nottelegraham/AlkTrack/Formula.png

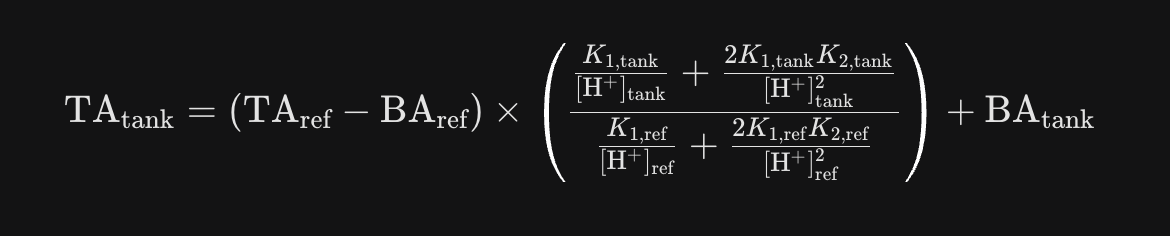
Formula.png
