nottelegraham/AlkTrack/thumbnail.png

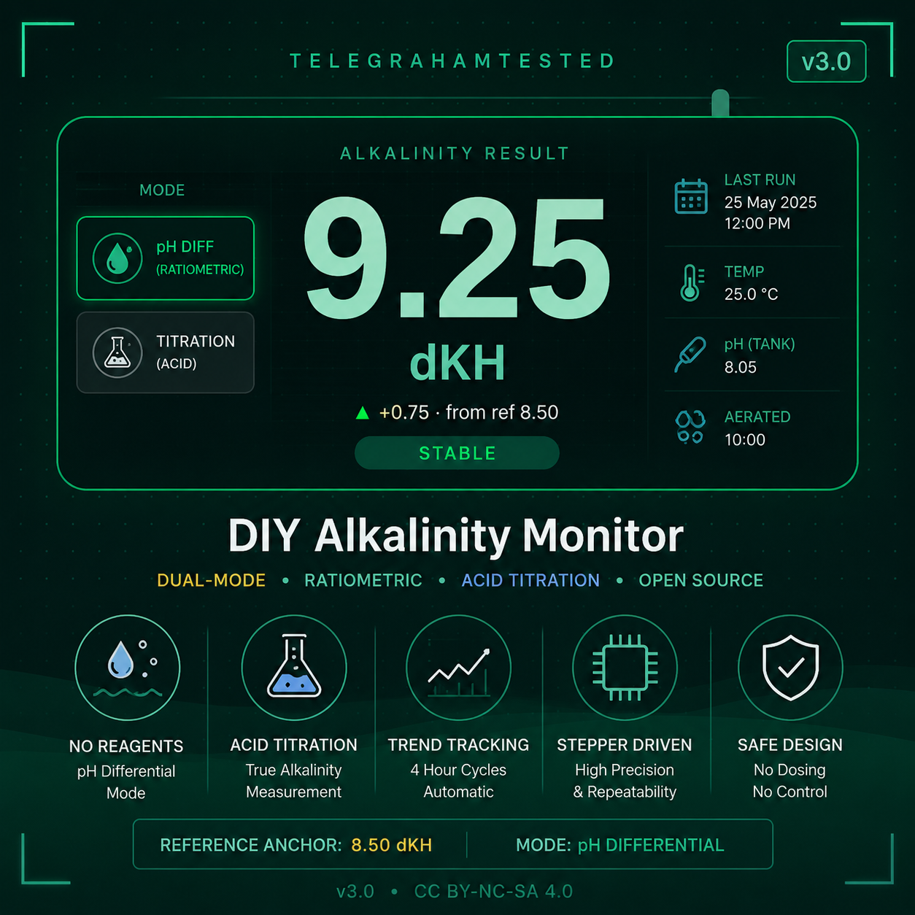
thumbnail.png
