nottelegraham/AlkTrack/DIY_Alkalinity_Monitor_Price_Sheet_v3_0.xlsx

AlkTrack DIY Alkalinity Monitor — v3.0 Component Price Sheet
TelegrahamTested • Firmware v3.0 • Dual-mode pH differential + acid titration • Approx. US retail
Qty | Item | Notes | Low ($) | High ($) | Subtotal (mid)
ELECTRONICS
1 | ESP32 DevKit C (38-pin) | Espressif or clone. Use 38-pin standard pinout; avoid ESP32 GPIO 6-11. | $8.00 | $12.00 | $10.00
1 | Atlas Scientific EZO-pH Circuit | Recommended pH interface. Cheap high-impedance boards often drift/noise. | $43.00 | $47.00 | $45.00
1 | Atlas EZO isolated carrier board | Mandatory isolation between pH circuit and pump/driver power. | $23.00 | $27.00 | $25.00
1 | Lab-grade double-junction pH probe | BNC, gel-filled, epoxy/Ultem body. Most important purchase. | $60.00 | $130.00 | $95.00
1 | DS18B20 waterproof temperature probe | 1-wire digital probe, 4.7 kΩ pullup required. | $5.00 | $8.00 | $6.50
4 | A4988 or DRV8825 stepper drivers | One per pump; set current limit and use heat sinks. | $3.00 | $7.00 | $20.00
1 | 12V DC supply, 5A minimum | Stepper-driven pumps require more current than v2 relay pumps. | $14.00 | $25.00 | $19.50
1 | 5V/USB supply for ESP32 | Separate logic supply recommended. | $5.00 | $8.00 | $6.50
1 | Perfboard / terminal blocks / wiring | For tidy wiring, pullup, and service loops. | $8.00 | $20.00 | $14.00
PUMPS & FLUIDICS
1 | Stepper peristaltic pump A | Reference reservoir to/from reaction chamber; reversible. | $35.00 | $70.00 | $52.50
1 | Stepper peristaltic pump B | Tank/sample fill pump; step-counted volume control. | $35.00 | $70.00 | $52.50
1 | Stepper peristaltic pump C | Reaction chamber drain/evacuation; routes titration waste to waste container. | $35.00 | $70.00 | $52.50
1 | Stepper peristaltic pump D | Acid reagent dosing pump. Highest calibration priority. | $35.00 | $80.00 | $57.50
1 | Micro diaphragm air pump | Fine bubbles for aeration and titration mixing pulses. | $8.00 | $15.00 | $11.50
1 | Ceramic fine-bubble airstone | Small enough for 40-60 mL chamber. | $2.00 | $5.00 | $3.50
4 | Tubing, 3 mm ID, peristaltic compatible | Meters. Buy extra for calibration and replacement. | $3.00 | $5.00 | $16.00
1 | Bulkhead fittings / tube glands set | Ports for chamber, reservoirs, and rear panel. | $10.00 | $20.00 | $15.00
CONTAINERS & HARDWARE
1 | Reference reservoir bottle | 500-1000 mL HDPE or Nalgene-style bottle. | $12.00 | $30.00 | $21.00
1 | Acid reagent reservoir | 250-500 mL acid-resistant HDPE bottle; label ACID - HCl. | $8.00 | $20.00 | $14.00
1 | Waste collection container | Closed HDPE container for acidified titration waste. | $5.00 | $12.00 | $8.50
1 | Reaction chamber / measurement cell | 40-60 mL clear acrylic/PETG with pH, temp, air, sample, drain, and acid ports. | $20.00 | $60.00 | $40.00
1 | Electronics enclosure | ABS project box; separate wet and dry areas. | $12.00 | $25.00 | $18.50
1 | Drip tray / leak containment | Recommended under wet components. | $5.00 | $20.00 | $12.50
1 | Misc. sealant, cable clips, labels | Mounting, waterproofing, acid/waste labels. | $8.00 | $15.00 | $11.50
CONSUMABLES
1 | 0.1N HCl titrant or known-normality acid | Required only for MODE TITR. Store capped and labelled. | $10.00 | $25.00 | $17.50
1 | pH 7.00 and pH 4.01 calibration buffers | Required for pH probe calibration. | $8.00 | $20.00 | $14.00
1 | Baking soda for neutralizing waste | Required for acid waste neutralization. | $2.00 | $5.00 | $3.50
PHYSICAL BUILD / TOOLS
1 | Reaction chamber fabrication | DIY drilling/tapping or outsourced 3D print/machining. | $0.00 | $60.00 | $30.00
1 | Step drill bits / hole saws | For enclosure cutouts and bulkhead fittings. | $0.00 | $20.00 | $10.00
1 | Solder, heat shrink, connectors | Wiring consumables. | $5.00 | $15.00 | $10.00
SUMMARY |  |  | Low ($) | High ($) | Mid ($)
Electronics |  |  | $169.00 | $284.00 | $241.50
Pumps & Fluidics |  |  | $163.00 | $335.00 | $261.00
Containers & Hardware |  |  | $70.00 | $182.00 | $126.00
Consumables |  |  | $20.00 | $50.00 | $35.00
Physical Build / Tools |  |  | $5.00 | $95.00 | $50.00
COMPONENTS TOTAL |  |  | $427.00 | $946.00 | $713.50
Notes
v3.0 includes both pH differential and acid titration modes. Titration mode requires acid reagent, Pump D, and an acid waste container.
Do not return titration waste to the aquarium. Any sample that receives acid must go to waste and be neutralized before disposal.
pH probe quality and pump calibration dominate measurement reliability.
