nottelegraham/AlkTrack/Version 2/DIY_Alkalinity_Monitor_Price_Sheet.xlsx

DIY Ratiometric Alkalinity Monitor — Component Price Sheet
TelegrahamTested • Firmware v2.2 • All prices approximate US retail
Qty | Item | Notes | Low ($) | High ($) | Subtotal (mid)
ELECTRONICS
1 | ESP32 DevKit C (38-pin) | Espressif or clone. Must be 38-pin standard pinout. Do not buy the 30-pin variant. | $8.00 | $12.00 | $10.00
1 | Atlas Scientific EZO-pH Circuit | Isolated version (EZO-pH). Cheap alternatives produce unusable noise. | $43.00 | $47.00 | $45.00
1 | Atlas EZO Isolated Carrier Board | Part: EZO-PMP-ISO. Mandatory — eliminates pump motor noise from pH readings. | $23.00 | $27.00 | $25.00
1 | Lab-grade double-junction pH probe | BNC connector, gel-filled, epoxy/Ultem body. Atlas or Hanna HI1083. This is the most critical purchase — do not skimp. | $60.00 | $130.00 | $95.00
1 | DS18B20 waterproof temp probe | 1-meter stainless steel sheath. 1-Wire digital. Any brand. | $5.00 | $8.00 | $6.50
1 | 4-channel relay module, 5V opto-isolated | Controls all 4 pumps. Must be opto-isolated. Active-LOW most common — see wiring notes. | $7.00 | $10.00 | $8.50
1 | 4.7 kΩ resistor | Pullup for DS18B20 data line. Often included in DS18B20 kits. | $0.50 | $1.00 | $0.75
1 | 12V 2A DC power supply | Powers pumps. Standard barrel connector. | $8.00 | $12.00 | $10.00
1 | 5V 1A supply or USB phone charger | Powers ESP32. | $5.00 | $8.00 | $6.50
1 | Breadboard or small perfboard | For pullup resistor and wiring connections. | $3.00 | $6.00 | $4.50
1 | Jumper wire assortment | Male-to-male and male-to-female, 20 cm. | $5.00 | $8.00 | $6.50
PUMPS & FLUIDICS
1 | Reversible peristaltic pump, 12V (Pump A) | Must run both directions. Kamoer FX-STP or similar. Draws from and returns to reference reservoir. | $35.00 | $60.00 | $47.50
1 | Reversible peristaltic pump, 12V (Pump B) | Must run both directions, same as Pump A. Draws tank water in and returns it to the sump after measurement. Kamoer FX-STP or similar. | $35.00 | $60.00 | $47.50
1 | Micro diaphragm air pump | 5V or 12V. Fine bubbles required. Tetra Whisper or small aquarium air pump. | $8.00 | $12.00 | $10.00
1 | Ceramic fine-bubble airstone | Small, fits inside reaction chamber. Pre-soak in RO water before first use. | $2.00 | $5.00 | $3.50
2 m | Silicone tubing, 3 mm ID | Food-safe, peristaltic-pump compatible. Buy extra for calibration runs. | $6.00 | $10.00 | $8.00
4 | Barbed fittings & check valves | Prevents back-siphoning. Critical if sump is above the chamber. | $8.00 | $12.00 | $10.00
CONTAINERS & HARDWARE
1 | Reference reservoir bottle | 500–1000 mL HDPE, wide-mouth. Requires three cap ports: Pump A tubing, PTFE vent plug, and one spare. Nalgene or equivalent. | $12.00 | $30.00 | $21.00
2 | PTFE hydrophobic membrane vent plug | Polytetrafluoroethylene membrane vent for reservoir cap. Allows pressure equalization without liquid evaporation. CO₂ passing through does NOT affect alkalinity — TA is conserved. One installed, one spare. Lab supply or aquarium store. | $2.00 | $8.00 | $5.00
1 | Reaction chamber / measurement cell | 40–60 mL. Clear acrylic tube + end caps, or 3D-printed PETG. Needs ports for pH probe, temp probe, airline, sample in, drain out. | $20.00 | $50.00 | $35.00
1 | Electronics enclosure | ABS project box. Weatherproof if near sump. | $10.00 | $15.00 | $12.50
1 | Bulkhead fittings, 1/4" or 3/8" | Seals tubing penetrations into reservoir and chamber walls. | $8.00 | $12.00 | $10.00
1 | Misc: zip ties, sealant, cable clips | Mounting, waterproofing, cable management. | $6.00 | $10.00 | $8.00
PHYSICAL BUILD (NOT INCLUDED ABOVE)
— | Fabrication — reaction chamber ports | Drilling and tapping probe/tube ports into acrylic or PETG. DIY: ~$0 if you own a drill. Professional shop: variable. | $0.00 | $60.00 | $30.00
— | 3D printing — reaction chamber shell | If outsourcing. JLCPCB or local shop. DIY with own printer: filament ~$2. | $0.00 | $40.00 | $20.00
— | Solder, heat shrink, connectors | Misc electronics consumables for wiring the relay module and probe connections. | $5.00 | $15.00 | $10.00
— | Step drill bits for enclosure cutouts | For probe glands, cable glands, and power entry in the electronics box. | $0.00 | $20.00 | $10.00
— | Drip tray | Under all fluidic components. Tupperware or custom-cut acrylic sheet. | $5.00 | $20.00 | $12.50
SUMMARY |  |  | Low ($) | High ($) | Mid ($)
Electronics |  |  | $167.50 | $269.00 | $218.25
Pumps & Fluidics |  |  | $94.00 | $159.00 | $126.50
Containers & Hardware |  |  | $58.00 | $125.00 | $91.50
Physical Build (additional) |  |  | $10.00 | $155.00 | $82.50
COMPONENTS TOTAL |  |  | $319.50 | $553.00 | $436.25
ALL-IN ESTIMATE (incl. physical build) |  |  | $329.50 | $708.00 | $518.75
⚠ pH probe is the most critical purchase. A cheap probe makes the device useless — the ΔpH signal is only 0.02 pH per 0.5 dKH change.
⚠ Physical build costs assume DIY fabrication. Professional machining or outsourced 3D printing adds cost not captured above.
ℹ Prices are approximate US retail (2024–2025). Amazon, Digikey, Atlas Scientific, and BRS are the primary sources.
ℹ Tools not included: soldering iron, drill, multimeter, wire strippers. Add ~$50–$100 if starting from scratch.
