nottelegraham/AlkTrack/DIY_Alkalinity_Monitor_Build_Guide.docx

AlkTrack DIY Alkalinity Monitor

Complete Build Guide • TelegrahamTested • Firmware v3.0 • Dual-mode pH differential + acid titration

# 1. What This Device Does

AlkTrack v3.0 is a DIY, non-commercial reef aquarium alkalinity monitor with two selectable modes. In pH differential mode, it estimates alkalinity trend by comparing an aerated reference sample and an aerated tank sample. In acid titration mode, it performs a traditional fixed-volume acid-demand alkalinity test.

WARNING: Version 3.0 is not only a reagent-free trend monitor. Titration mode consumes known-strength acid reagent and produces acidic waste.

## Operating Modes

Mode | What it uses | What it produces | Best use
pH differential (MODE PHDI) | Reference reservoir, tank sample, air pump, pH probe, temperature probe | Reference-anchored alkalinity trend estimate | Monitoring direction: rising, falling, stable
Acid titration (MODE TITR) | Fixed tank-water sample, 0.1N acid reagent, pH endpoint detection | True acid-demand alkalinity result | Periodic confirmation or higher-confidence automated test

## How the Math Works

pH differential mode uses the reference-anchored carbonate-speciation ratio:

TA_tank = (TA_ref - BA_ref) × carbonate_speciation_ratio + BA_tank

The carbonate speciation ratio compares K1, K2, and hydrogen ion activity derived from the reference and tank pH readings. This is a trend estimator, not a laboratory-grade absolute method.

Acid titration mode uses:

dKH = (N_acid × V_acid_mL / V_sample_mL) × 2800

The factor 2800 converts equivalents per liter to dKH when acid normality is in eq/L and both volumes are in mL.

# 2. Shopping List

All prices are approximate US retail. Exact models can vary; what matters is meeting the specification in the Notes column.

## Electronics

Qty | Item | Notes | Est. Cost
1 | ESP32 DevKit C (38-pin) | Espressif or equivalent. Avoid 30-pin variants if you need all listed GPIO. | $8-$12
1 | Atlas Scientific EZO-pH Circuit | Use a reliable high-impedance pH interface. Atlas EZO-pH is the recommended baseline. | $43-$47
1 | Atlas electrically isolated carrier board | Mandatory for stable pH readings near pump wiring. | $23-$27
1 | Lab-grade double-junction pH probe | BNC connector, gel-filled, epoxy or Ultem body. Do not use a bargain probe. | $60-$130
1 | DS18B20 waterproof temperature probe | 1-wire digital temperature probe with 4.7 kΩ pullup. | $5-$8
4 | A4988 or DRV8825 stepper drivers | One driver per pump. Use heat sinks and set current limit correctly. | $12-$28
1 | 12V DC power supply, 5A minimum | Stepper pumps require more current than relay-switched DC pumps. | $14-$25
1 | 5V/USB supply for ESP32 | Separate logic power is recommended. | $5-$8
1 | Perfboard / terminal blocks / wiring | For clean connections and serviceability. | $8-$20

## Pumps and Fluidics

Qty | Item | Notes | Est. Cost
1 | Stepper peristaltic pump A | Reference reservoir to/from reaction chamber. Reversible. | $35-$70
1 | Stepper peristaltic pump B | Tank/sample fill pump. Step-counted volume control. | $35-$70
1 | Stepper peristaltic pump C | Chamber drain/evacuation pump. Routes to waste in titration mode. | $35-$70
1 | Stepper peristaltic pump D | Acid reagent dosing pump. Highest calibration priority. | $35-$80
1 | Micro diaphragm air pump | Provides repeatable aeration/mixing pulses. | $8-$15
1 | Ceramic fine-bubble airstone | Small enough for the reaction chamber. | $2-$5
2-4 m | Peristaltic-compatible tubing | Buy extra for calibration, replacement, and mistakes. | $8-$16
— | Bulkhead fittings / tubing glands | For chamber, reservoir, acid bottle, and rear panel. | $10-$20

## Containers and Hardware

Qty | Item | Notes | Est. Cost
1 | Reference reservoir bottle | 500-1000 mL HDPE or Nalgene-style bottle. | $12-$30
1 | Acid reagent reservoir | 250-500 mL acid-resistant HDPE bottle labelled ACID - HCl. | $8-$20
1 | Waste collection container | Closed HDPE container labelled ACID WASTE. Required for titration mode. | $5-$12
1 | Reaction chamber / measurement cell | 40-60 mL clear acrylic/PETG chamber with probe, air, sample, drain, and acid ports. | $20-$60
1 | Electronics enclosure | ABS project box. Keep fluidics separated from electronics. | $12-$25
— | Drip tray / leak containment | Recommended under all wet components. | $5-$20

# 3. Wiring

The ESP32 does not drive stepper motors directly. Each peristaltic pump uses one A4988 or DRV8825 driver. The ESP32 sends STEP and DIR pulses; firmware converts calibrated steps to mL.

WARNING: Do not use ESP32 GPIO 6, 7, 8, 9, 10, or 11. These are connected to internal SPI flash.

Function | ESP32 GPIO | Connect to
Pump A STEP | GPIO 23 | Pump A stepper driver STEP
Pump A DIR | GPIO 22 | Pump A stepper driver DIR
Pump B STEP | GPIO 21 | Pump B stepper driver STEP
Pump B DIR | GPIO 19 | Pump B stepper driver DIR
Pump C STEP | GPIO 18 | Pump C stepper driver STEP
Pump C DIR | GPIO 5 | Pump C stepper driver DIR
Pump D STEP | GPIO 27 | Pump D acid pump driver STEP
Pump D DIR | GPIO 26 | Pump D acid pump driver DIR
Air pump | GPIO 4 | MOSFET or relay driver for air pump
DS18B20 data | GPIO 14 | DS18B20 yellow/data wire + 4.7 kΩ pullup
EZO-pH RX | GPIO 16 | EZO carrier TX
EZO-pH TX | GPIO 17 | EZO carrier RX
Optional DAC output | GPIO 25 | Isolated DAC or buffer stage only

## Stepper Driver Notes

- Set current limits before connecting pumps.
- Use 1/16 microstepping for water pumps as a starting point.
- Use 1/16 or 1/32 microstepping for the acid pump if the driver and pump support it.
- All volume-critical pumps must be calibrated in steps per mL before use.
- Keep pH signal wiring physically separated from motor wiring.

# 4. Fluidic Layout

Recommended v3.0 dual-mode fluid path:

Pump | Inlet | Outlet | Purpose
Pump A | Reference reservoir | Reaction chamber | Fill/reference return path; reversible
Pump B | Sump or tank sample inlet | Reaction chamber | Step-counted tank/sample fill
Pump C | Reaction chamber | Waste container or controlled drain | Evacuates chamber; routes acidic titration waste away from tank
Pump D | Acid reagent reservoir | Reaction chamber | Adds measured acid increments in titration mode

WARNING: Do not return titration waste to the aquarium. Any sample that receives acid reagent must go to a waste container.

# 5. Software Setup

1. Install Arduino IDE 2.x.
2. Install ESP32 board support by Espressif Systems.
3. Install OneWire and DallasTemperature libraries if SIMULATION_MODE is false.
4. Open alkalinity_monitor_v3_0.ino.
5. Verify and upload with SIMULATION_MODE true for bench testing.
6. Open Serial Monitor at 115200 baud and send STATUS.
7. After wiring and calibration, set SIMULATION_MODE false and re-upload.

# 6. First-Time Calibration

## pH differential mode

8. Fill the reference reservoir with fresh aquarium water.
9. Manually test that exact water with a hobby alkalinity titration kit.
10. Enter the value with CAL 8.50, replacing 8.50 with your measured dKH.
11. Prime Pump A and tank lines with PRIME.
12. Select MODE PHDI and run RUN.

## Titration mode

13. Prepare labelled 0.1N HCl reagent or another known-normality acid.
14. Set acid normality, for example CAL ACID 0.1000.
15. Set sample volume, for example CAL SAMPLEML 25.0.
16. Calibrate sample pump steps/mL with CAL SAMPLESPM.
17. Calibrate acid pump steps/mL with CAL ACIDSPM.
18. Select MODE TITR and run RUN.
19. Confirm first results against a manual test before trusting automation.

# 7. Safety

- Use eye protection when handling acid reagent.
- Label acid and waste containers clearly.
- Neutralize acidic waste with baking soda before disposal.
- Never route acid-exposed sample water back to the aquarium.
- Use a drip tray and keep electronics above and separated from the wet bay.
- Do not let AlkTrack directly control dosing without conservative safeguards and manual confirmation.

TelegrahamTested • AlkTrack v3.0 • CC BY-NC-SA 4.0
