nottelegraham/AlkTrack/DIY_Alkalinity_Monitor_User_Guide.docx

AlkTrack DIY Alkalinity Monitor

User Guide • TelegrahamTested • Firmware v3.0 • Dual operating modes

# What this device does

AlkTrack v3.0 can operate in two user-selectable modes.

- MODE PHDI: pH differential/ratiometric alkalinity trend monitoring. Reagent-free, reference-anchored, intended for trends.
- MODE TITR: acid titration alkalinity testing. Uses known-strength acid reagent, endpoint detection, and a fixed tank-water sample volume.

WARNING: pH differential mode is a trend estimator. Titration mode is a chemical test. Both require periodic manual verification.

# 1. Before You Start

- Built and wired unit with stepper pumps, stepper drivers, pH probe, temperature probe, and air pump connected.
- Reference reservoir filled and manually tested if using pH differential mode.
- Acid reagent reservoir and acid waste container prepared if using titration mode.
- pH probe calibrated with pH 7.00 and pH 4.01 buffers.
- Computer with Arduino IDE and Serial Monitor at 115200 baud.
- SIMULATION_MODE set appropriately.

WARNING: Galvanic isolation for the pH circuit is mandatory. Pump noise can create believable but wrong pH readings.

# 2. Selecting an Operating Mode

Command | Mode | Use when
MODE PHDI | pH differential | You want reagent-free trend monitoring.
MODE TITR | Acid titration | You want a true acid-demand alkalinity test.

The selected mode is stored in EEPROM and persists across power cycles.

# 3. First-Time Setup

## pH differential setup

1. Draw 500-700 mL of aquarium water into a clean container.
2. Manually test that exact water for alkalinity.
3. Put the water into the reference reservoir and seal it.
4. Enter the result with CAL 8.50, replacing 8.50 with your value.
5. Send MODE PHDI.
6. Send PRIME to fill tubing.
7. Send RUN for the first cycle.

## Acid titration setup

8. Fill the acid reservoir with known-strength titrant, commonly 0.1N HCl.
9. Label the acid reservoir and waste container.
10. Set acid normality with CAL ACID 0.1000.
11. Set sample volume with CAL SAMPLEML 25.0.
12. Calibrate sample pump steps/mL with CAL SAMPLESPM.
13. Calibrate acid pump steps/mL with CAL ACIDSPM.
14. Send MODE TITR.
15. Run a test and compare against a manual alkalinity test.

# 4. Running a Measurement

Send RUN to start an immediate cycle. During normal operation the device can run on its scheduled interval.

## pH differential cycle

- Pump A draws reference water into the reaction chamber.
- The air pump aerates the reference sample.
- The pH and temperature probes record averaged values.
- Pump A returns the reference water to the reservoir.
- The chamber is rinsed with tank water.
- Pump B fills the chamber with tank water.
- The tank sample is aerated and measured.
- The firmware calculates a reference-anchored alkalinity trend estimate.

## Acid titration cycle

- Pump B fills a fixed sample volume into the reaction chamber.
- The air pump mixes or preconditions the sample.
- Pump D adds acid reagent in measured increments.
- The pH probe tracks the pH response after each dose.
- The firmware detects endpoint volume using Gran fitting when possible, with fixed endpoint fallback.
- Pump C drains the acidified sample to waste.
- The firmware calculates dKH from acid normality, acid endpoint volume, and sample volume.

WARNING: Do not return titration-mode sample water to the aquarium after acid has been added.

# 5. Serial Commands

Command | What it does
STATUS | Show current mode, calibration values, and last result.
RUN | Trigger an immediate measurement cycle.
MODE PHDI | Switch to pH differential/ratiometric mode.
MODE TITR | Switch to acid titration mode.
CAL 8.50 | Set reference anchor for pH differential mode.
CAL ACID 0.1000 | Set acid normality for titration mode.
CAL SAMPLEML 25.0 | Set titration sample volume in mL.
CAL DOSE 0.020 | Set acid dose increment in mL.
CAL SAMPLESPM 3200 | Set sample pump calibration in steps/mL.
CAL ACIDSPM 6400 | Set acid pump calibration in steps/mL.
PRIME | Prime tubing lines.
PUMPS_OFF | Emergency stop and abort.

# 6. Interpreting Results

Observation | Likely meaning
pH differential result slowly rises | Dosing may be running ahead of consumption or consumption has dropped.
pH differential result slowly falls | Dosing may be behind consumption or consumption has increased.
Back-to-back pH differential jumps >1 dKH | Probe, fluidics, aeration, or reference drift issue. Do not dose from that single result.
Titration result differs from manual test by >0.5 dKH | Check acid normality, pump calibration, endpoint detection, pH calibration, and sample volume.
pH standard deviation warning | Sample pH was still drifting during averaging or endpoint reading.

# 7. Maintenance

Interval | Task
Weekly | Inspect tubing, fittings, chamber, air bubbles, acid reservoir, and waste container.
Monthly | Recalibrate pH probe with pH 7.00 and 4.01 buffers. Verify reference reservoir if using pH differential mode.
Monthly or after tubing changes | Re-check steps/mL calibration for sample and acid pumps.
Every 3-6 months | Refresh reference reservoir and re-anchor. Clean reaction chamber.
Every 6-12 months | Replace peristaltic pump tubing and re-prime.

# 8. Safety and Limitations

- pH differential mode is not a lab-grade alkalinity test.
- Titration mode creates acidic waste and must be routed to a waste container.
- Never use a single bad reading for aggressive dosing decisions.
- Probe calibration and pump calibration are not optional.
- Simulation mode produces fake values and must be turned off for real measurements.

TelegrahamTested • AlkTrack v3.0 • CC BY-NC-SA 4.0
