nottelegraham/AlkTrack/Version 2/DIY_Alkalinity_Monitor_User_Guide.docx

DIY Ratiometric Alkalinity Monitor

User Guide

TelegrahamTested • Firmware v2.2

What this device does

Automatically tracks whether your reef tank’s alkalinity is rising, falling, or stable — every 4 hours, without chemicals or titration. Not a replacement for occasional manual testing. A consistent trend monitor.

# 1. Before You Start

Read this section fully before connecting anything to power or water.

## What you need ready

- Built and wired unit with all pumps, probes, and relay board connected
- Reference reservoir filled with 500–700 mL of aquarium water and sealed
- Manual titration kit result for that reservoir water (Salifert, Hanna HI772, or equivalent)
- Computer with Arduino IDE installed and the firmware uploaded
- USB cable connected to the ESP32
- Serial Monitor open at 115200 baud

⚠ Galvanic isolation is mandatory

The Atlas EZO-pH circuit MUST be on an electrically isolated carrier board before any pump wiring is connected to power. Running the pump drivers and pH probe on a shared ground will produce corrupted pH readings that look plausible but are wrong. The firmware cannot detect this. Verify isolation before first power-on.

⚠ Simulation mode is on by default

The firmware ships with SIMULATION_MODE true. In this mode the pH probe and temperature probe return fake values. You will see readings and results, but they are not real measurements. Set SIMULATION_MODE false in the code and re-upload before trusting any output.

# 2. First-Time Setup

Complete these steps in order. Do not skip to “Running a Measurement” before finishing all of them.

## Step 1 — Fill and seal the reference reservoir

1. Draw 500–700 mL of water directly from your aquarium sump into a clean container.
2. Test that exact water with your titration kit. Write down the result in dKH. This number is your anchor.
3. Pour the water into the reference reservoir bottle. Seal it completely with the bulkhead fittings and tubing attached.
4. Label the bottle with the date and the measured dKH value.

ℹ Why it matters

The reservoir water is the fixed reference point all future measurements are compared against. Its alkalinity must be known precisely and must not change. Seal it well — even slow CO₂ exchange through a loose cap will drift its chemistry over weeks.

## Step 2 — Calibrate the pH probe

The EZO-pH probe must be calibrated before real measurements begin. Two-point calibration (pH 7.00 and pH 4.01) is minimum.

5. Connect to the EZO circuit directly via a serial terminal at 9600 baud, or temporarily patch it to the Serial Monitor.
6. Place the probe in the pH 7.00 buffer solution. Wait at least 60 seconds for the reading to stabilize. Send:

Cal,mid,7.00

7. Rinse the probe with deionized or RO water. Place it in the pH 4.01 buffer. Wait 60 seconds. Send:

Cal,low,4.01

8. Rinse again. The probe is now calibrated. Store it submerged in storage solution or pH 7 buffer when not in use.

Recalibrate the probe every 1–3 months, or any time results begin to diverge from your manual kit by more than 0.5 dKH.

## Step 3 — Switch off simulation mode

9. Open alkalinity_monitor_v2_1.ino in Arduino IDE.
10. Find line 1 at the top of the file:

#define SIMULATION_MODE true

11. Change it to:

#define SIMULATION_MODE false

12. Click the Upload arrow. Wait for the upload to complete and the board to restart.

## Step 4 — Set your reference anchor

Open the Serial Monitor (Tools → Serial Monitor, baud 115200). The device will prompt for an anchor if none is stored. Type your Day 1 titration result and press Enter:

CAL 8.50

Replace 8.50 with your actual measurement. The device confirms: Anchor saved: 8.50 dKH. This value is written to EEPROM and survives power cycles.

## Step 5 — Prime all tubing

On first install, all tubing is full of air. The PRIME command runs each pump long enough to push the air out and fill every line with water.

PRIME

The device runs four priming stages automatically and reports progress in the Serial Monitor. Watch for water flowing through each line:

- Pump A forward (30 s) — reference reservoir line fills toward chamber
- Pump A reverse (30 s) — water returns to reservoir
- Pump B forward (20 s) — sump line fills toward chamber
- Pump B reverse (20 s) — water returns to sump

⚠ Check for leaks after PRIME

Inspect every tubing connection, bulkhead fitting, and pump head for drips before proceeding. A slow leak near the electronics enclosure can cause a serious failure. Fix any leak completely before running a measurement cycle.

# 3. Running a Measurement

## Automatic cycle (normal operation)

Once setup is complete, the device runs automatically. After each completed cycle it sleeps for 4 hours, then runs again. No interaction is needed during normal operation.

## Manual cycle trigger

To run a cycle immediately without waiting for the 4-hour timer, send:

RUN

The cycle begins at the next 100 ms check interval (within one second). This works during the inter-cycle sleep. It does not interrupt a cycle already in progress.

## What happens during a cycle

Each cycle runs five phases in sequence. Total duration is approximately 25–30 minutes.

Phase | Duration | What is happening
A | ~15 s | Pump A draws ~30 mL from the sealed reference reservoir into the reaction chamber.
B | 10 min | Air pump aerates the reference sample. Room CO₂ diffuses into the water until the dissolved CO₂ matches atmospheric concentration.
C | ~2 min | pH and temperature are measured and averaged over 60 seconds (30 readings, 2 s apart). Air pump is off before reading begins.
D | ~30 s + 2× 20 s | Reference water returns to reservoir via Pump A reverse. Chamber is flushed twice with tank water (returned to sump via Pump B reverse) to prevent cross-contamination.
E | ~15 s + 10 min + ~2 min + ~20 s | Tank sample fills (Pump B forward), aerates identically, is measured, returns to sump (Pump B reverse), and result is calculated and reported.

## Reading the output

A completed cycle prints a result block in the Serial Monitor. Example:

[REF] T=25.40 C Averaging pH for 60 s...

pH=8.0982 SD=0.00312 n=30

[TANK] T=25.38 C Averaging pH for 60 s...

pH=8.1204 SD=0.00281 n=29

RESULT: 9.12 dKH

pH ref: 8.0982

pH tank: 8.1204

DeltapH tank-ref: +0.0222

Temp ref: 25.40 C

Temp tank: 25.38 C

Anchor: 8.50 dKH

Key values to watch:

- RESULT — the calculated alkalinity in dKH. This is the primary output.
- SD — pH standard deviation during the 60-second averaging window. Should be below 0.010. If higher, CO₂ may not have fully equilibrated — see Troubleshooting.
- DeltapH — the raw pH difference between reference and tank. Watch how this moves cycle to cycle. A rising delta means rising alkalinity.
- n — number of valid pH readings used in the average. Should be 20–30. If below 10, investigate the probe.

# 4. Serial Commands

All commands are sent via Serial Monitor at 115200 baud. Commands are not case-sensitive. Press Enter after typing each one.

Command | What it does
CAL 8.50 | Sets the reference anchor in dKH. Replace 8.50 with your titration result. Saves to EEPROM immediately. Use this whenever you remake the reference reservoir or the device consistently disagrees with your manual kit.
STATUS | Prints the current anchor value, simulation mode state, and the last calculated result.
RUN | Triggers an immediate measurement cycle. Works only during the inter-cycle sleep, not during an active cycle.
PRIME | Primes all tubing lines by running each pump in sequence. Use on first install and after any tubing replacement. Takes approximately 90 seconds.
PUMPS_OFF | Emergency stop. Immediately turns off all pumps and aborts the active cycle. Chamber water is returned to sump on clean abort; after PUMPS_OFF during a fill, run PRIME before restarting.

ℹ After PUMPS_OFF

Sending PUMPS_OFF during a reference aeration phase returns the reference water to the reservoir before stopping (this was a bug in earlier versions — it is fixed in v2.1.1). After PUMPS_OFF the chamber may still contain tank water if the abort happened during the tank phase. Send PRIME to flush the chamber before starting a new cycle.

# 5. Interpreting Results

This device is a trend and movement monitor. A single cycle result is less meaningful than the pattern across many cycles. Look for direction, not just the number.

## What the numbers mean

What you see | What it likely means
Result is close to anchor (within 0.3 dKH) | Tank alkalinity is near the reference value. System is stable or well-matched.
Result rising across several cycles | Dosing is running ahead of consumption, or coral consumption has dropped. Reduce two-part or kalkwasser dose.
Result falling across several cycles | Dosing is behind consumption, or coral growth has accelerated. Increase dose.
Result jumps ±1+ dKH between back-to-back cycles | Probe fouling, probe needs recalibration, or a fluidics problem (cross-contamination, incomplete fill). Do not act on the number — investigate first.
SD warning printed in Serial Monitor | pH was still drifting during the averaging window. CO₂ may not have equilibrated. Check the airstone is producing fine bubbles; consider increasing AERATE_TIME_MS to 900000 (15 min).
n below 15 on most cycles | The pH probe is responding slowly or dropping readings. Check EZO wiring and isolation. Probe may need cleaning.
RESULT: ERROR printed | Result fell outside 3–20 dKH plausible range. Check anchor value and probe calibration.

## Cross-checking with your manual kit

Cross-check the device against a manual titration kit at least every two weeks. Compare the device result from the most recent cycle against your manual test of tank water taken at the same time.

- Difference under 0.5 dKH consistently — the device is tracking well. No action needed.
- Difference 0.5–1.0 dKH consistently — consider re-anchoring. Test the reference reservoir water with the manual kit and update the anchor with CAL.
- Difference over 1 dKH consistently — recalibrate the pH probe first. If the gap persists after calibration, remake the reference reservoir and re-anchor.

## What this device cannot tell you

- Absolute alkalinity to laboratory accuracy. It is a trend monitor, not a titrator.
- Whether a single abnormal reading is real or an artifact. Always wait for the next cycle before acting.
- Calcium, magnesium, or pH. It only measures the carbonate alkalinity of your tank sample relative to the reference.

# 6. Maintenance

How often | What to do
Weekly | Visually inspect all tubing for kinks, salt creep at fittings, or small drips. Check that the airstone is producing fine bubbles, not large irregular ones.
Monthly | Recalibrate the pH probe with fresh pH 7.00 and pH 4.01 buffer solutions. Test the reference reservoir water with your manual kit. If it has drifted more than 0.3 dKH from the stored anchor, update with CAL.
Every 3–6 months | Replace the reference reservoir water entirely. Draw fresh water from the tank, test it, and re-anchor. Inspect and clean the reaction chamber with dilute white vinegar, then rinse thoroughly with RO water.
Every 6–12 months | Replace the peristaltic pump tubing. PharMed BPT or equivalent silicone tubing is recommended. After replacement, run PRIME to fill the new lines.
As needed | If results become erratic, clean the pH probe tip with a soft cloth and mild detergent, rinse with RO water, and recalibrate. Replace the probe if cleaning does not restore stable readings (probes typically last 1–2 years in saltwater service).

# 7. Troubleshooting

### Device shows no output at startup

- Check that the Serial Monitor baud rate is set to 115200.
- Press the RST button on the ESP32 and watch for the startup message.
- If nothing appears, re-upload the firmware.

### No valid anchor — device stuck at startup

This is normal on first boot. Type CAL followed by your measured dKH value and press Enter. The device will proceed once a valid anchor is saved.

### EZO-pH shows no response

- Confirm TX and RX wires are not swapped. EZO TX goes to ESP32 GPIO 16. EZO RX goes to GPIO 17.
- Confirm the isolated carrier board has power and that its ground is not shared with the relay module.
- Send the letter i in Serial Monitor as a communications test. The EZO should reply with its device info.

### Pumps run at startup and stop when commanded

Your relay module is active-LOW, but the firmware uses active-HIGH logic. Move the wiring from the NO (normally open) terminal to the NC (normally closed) terminal on each relay, or purchase an active-HIGH relay module.

### SD warning printed — CO₂ equilibration warning

- The airstone may be partially blocked. Remove, clean in fresh RO water, and reinstall.
- The air pump may be underpowered. Check that it is producing a steady stream of fine bubbles throughout the aeration period.
- Increase AERATE_TIME_MS in the firmware from 600000 (10 min) to 900000 (15 min).

### Results consistently differ from manual kit by more than 1 dKH

13. Recalibrate the pH probe with fresh buffers.
14. Test the reference reservoir water with your manual kit. If it has drifted, update the anchor with CAL.
15. If the gap persists, remake the reference reservoir with fresh tank water and re-anchor.
16. Verify that the probe is fully submerged during measurements and that the airstone is off before readings begin.

### RESULT: ERROR or result outside 3–20 dKH range

- The most common cause is a pH probe read failure. Check wiring and EZO isolation.
- Verify the anchor value with STATUS. If it reads 0.00 or an impossible value, re-enter it with CAL.

### Chamber does not fill completely

Fill time is calibrated assuming the tubing is water-filled. On first run after PRIME, or after a pump replacement, increase FILL_TIME_MS temporarily. Verify by watching the chamber through its clear wall.

### DS18B20 reads −127 °C or shows disconnected

The 4.7 kΩ pullup resistor between GPIO 14 and 3.3 V is missing or not making contact. Verify it is in place and securely connected before troubleshooting the probe itself.

ℹ Still stuck?

Send STATUS in Serial Monitor and note all output. Check that Anchor value is reasonable (3–20 dKH), simulation mode reads NO, and the last result is not ERROR. Most issues trace back to: missing pullup resistor, swapped TX/RX, shared EZO ground with pump power, or an anchor value of 0.

# 8. Adjustable Settings

These constants are at the top of the firmware file. Change and re-upload to apply. Only change one at a time and verify behaviour before changing another.

Constant | Default | What it controls
AERATE_TIME_MS | 600000 (10 min) | How long each sample is aerated. Increase to 900000 (15 min) if the SD warning appears regularly.
FILL_TIME_MS | 15000 (15 s) | How long Pump A or B runs to fill the chamber. Adjust to match your pump flow rate and tubing length.
DRAIN_TIME_MS | 17000 (17 s) | How long Pump A rev and Pump B rev run to return water. Slightly longer than FILL_TIME_MS to ensure the chamber fully empties.
TEST_INTERVAL_MS | 14400000 (4 h) | Time between automated cycles. Reduce to 7200000 (2 h) for faster tracking, or increase to reduce pump wear.
SETTLE_TIME_MS | 5000 (5 s) | Pause after air pump stops before pH averaging begins. Allows bubbles to clear. Increase if turbulence persists.
PH_SD_WARN_THRESHOLD | 0.010 | Maximum pH standard deviation before a warning prints. Lower is stricter; 0.005 requires very stable equilibration.
READ_WINDOW_MS | 60000 (60 s) | Total pH averaging window duration. 30 readings at 2-second intervals.
MAP_DKH_LOW / HIGH | 6.0 / 12.0 | dKH range that maps to the DAC trend output voltage. Bracket your tank’s normal operating range.

TelegrahamTested • DIY Ratiometric Alkalinity Monitor • User Guide v2.1.1 • CC BY-NC-SA 4.0

This is a trend monitoring tool. Always cross-check with a manual titration kit before adjusting your dosing regime.

DIY Ratiometric Alkalinity Monitor User Guide
