nottelegraham/AlkTrack/Version 2/DIY_Alkalinity_Monitor_Build_Guide.docx

DIY Ratiometric Alkalinity Monitor

Complete Build Guide

TelegrahamTested • Firmware v2.1

What is this?

A reagent-free automated alkalinity trend monitor for reef aquariums. No chemicals, no titration. Uses carbonate chemistry to track whether your dKH is rising, falling, or stable — automatically, every 4 hours.

# 1. What This Device Does

This monitor tracks whether your reef tank's alkalinity is rising, falling, or staying stable — automatically, every 4 hours, without chemicals or manual titration.

It works by drawing a small water sample from your tank, aerating it alongside a sealed reference water sample under the same room air, then comparing their stabilized pH readings using carbonate chemistry math to estimate alkalinity. The result appears on your computer and outputs a synthetic voltage signal your aquarium controller can log as a trend line.

⚠ This is not a lab instrument. It will not replace occasional manual Salifert or Hanna titration checks. It is a consistent, repeatable trend monitor with roughly ±0.2 dKH repeatability — enough to catch dosing drift before it becomes a problem.

## How the Math Works

After aerating both water samples with the same room air, the unpredictable room CO₂ concentration becomes identical for both samples and cancels out of the calculation entirely. What remains is a direct comparison of the two samples’ carbonate chemistry, anchored to a known reference alkalinity you entered on Day 1. The formula is:

TAₜₐₙₖ = (TAᴿₑₑ − BAᴿₑₑ) × Carbonate Speciation Ratio + BAₜₐₙₖ

You do not need to understand the math to use the device. You need to: measure your reference water once with a manual test kit, enter the value, and let the firmware handle the rest.

# 2. Shopping List

All prices are approximate US retail. Exact models can vary — what matters is meeting the specification in the Notes column.

## Electronics

Qty | Item | Notes | Est. Cost
1 | ESP32 DevKit C (38-pin) | Espressif or any clone. Must be a 38-pin DevKit with standard pinout. Do not buy the 30-pin version — it omits needed GPIO. | $8
1 | Atlas Scientific EZO-pH Circuit | Buy the isolated version (EZO-pH). Part number on Atlas website: EZO-pH. Cheap alternatives produce drifting, noisy readings. | $45
1 | Atlas Scientific Electrically Isolated Carrier Board | Part: EZO-PMP-ISO or equivalent isolation carrier. Mandatory — eliminates pump motor noise from pH readings. | $25
1 | Lab-grade double-junction pH probe | BNC connector, gel-filled, epoxy or Ultem body. Atlas Scientific or Hanna HI1083. Budget probes ruin results. This is the most important purchase. | $60–$130
1 | DS18B20 waterproof temperature probe | 1-meter stainless steel sheath. Any brand. 1-Wire digital output. | $6
1 | 4-channel relay module, 5V, opto-isolated | Controls all 4 water pumps. Must be opto-isolated. Active-LOW trigger is most common — see wiring notes. | $8
1 | 4.7 kΩ resistor | Pullup for DS18B20 data line. Included in many DS18B20 kits. | <$1
1 | 12V 2A DC power supply | Powers the pumps. Standard barrel connector. | $10
1 | 5V 1A supply or USB phone charger | Powers the ESP32. | $6
1 | Breadboard or small perfboard | For pullup resistor and wiring connections. | $4
— | Jumper wires (male-to-male, male-to-female) | Assorted 20cm pack. | $6

## Pumps and Fluidics

Qty | Item | Notes | Est. Cost
1 | Reversible peristaltic pump, 12V (Pump A) | Must run in both directions. Kamoer FX-STP or similar. Draws from and returns water to the reference reservoir. | $35–$60
1 | Reversible peristaltic pump, 12V (Pump B) | Must run in both directions, same as Pump A. Draws tank water in and returns it to the sump after measurement. Kamoer FX-STP or similar. | $35–$60
1 | Micro diaphragm air pump | 5V or 12V. Produces fine bubbles. Tetra Whisper or small aquarium air pump. | $10
1 | Ceramic fine-bubble airstone | Small, to fit inside reaction chamber. Pre-soak in RO water before first use. | $3
2 m | Silicone tubing, 3 mm ID | Food-safe, peristaltic-pump compatible. Buy extra for testing. | $8
4 | Barbed fittings and check valves | Prevents back-siphoning. Critical if your sump is above the reaction chamber. | $10

## Containers and Hardware

Qty | Item | Notes | Est. Cost
1 | Reference reservoir | 500–1000 mL HDPE bottle, wide-mouth. Requires three ports in the cap: Pump A tubing, PTFE vent plug, and one spare. Nalgene or equivalent. | $15–$30
2 | PTFE hydrophobic membrane vent plug | Polytetrafluoroethylene membrane vent, installs in reservoir cap. Lets pressure equalize when water is pumped in and out without allowing evaporation. CO₂ passing through does not affect alkalinity — TA is a conservative property unaffected by CO₂ exchange. Buy two: one installed, one spare. | $2–$8
1 | Reaction chamber / measurement cell | 40–60 mL capacity. Clear acrylic tube with end caps, or 3D-printed PETG. Needs ports for: pH probe, temp probe, airline in, sample in (Pump A/B), drain out (Pump C). | $20–$50
1 | Enclosure for electronics | Small ABS project box. Weatherproof if near sump. | $12
— | Bulkhead fittings, 1/4 inch or 3/8 inch | For sealing tubing penetrations into reservoir and chamber walls. | $10
— | Zip ties, cable clips, silicone sealant | Mounting and waterproofing near water. | $8

Estimated Total: $360 – $548

The largest variable is the pH probe. A quality probe ($100+) is the most important single investment. A $10 probe will produce drifting, noisy readings that make the entire device useless.

## Tools Required

- Computer with Arduino IDE installed (free: arduino.cc)
- Micro-USB or USB-C cable to program the ESP32
- Small screwdrivers (Phillips and flathead)
- Wire strippers
- Multimeter (strongly recommended)
- Hot glue gun or silicone sealant for near-water connections

# 3. Wiring

The ESP32 cannot drive 12V pump motors directly. A relay module sits between them: the ESP32 sends a 5V control signal to the relay coil, and the relay switches 12V power to each pump motor independently.

## ESP32 Pin Assignments

⚠ Do not use GPIO 6, 7, 8, 9, 10, or 11. These are connected to the ESP32’s internal SPI flash. Driving them as outputs will crash or corrupt the board.

Function | ESP32 GPIO | Connect to
Pump A Forward (reference fill) | GPIO 23 | Relay module — channel 1 signal (IN1)
Pump A Reverse (reference return) | GPIO 19 | Relay module — channel 2 signal (IN2)
Pump B Forward (tank fill) | GPIO 18 | Relay module — channel 3 signal (IN3)
Pump B Reverse (tank return) | GPIO 5 | Relay module — channel 4 signal (IN4)
Air pump | GPIO 4 | 5th relay channel or MOSFET gate
DS18B20 temperature probe data | GPIO 14 | DS18B20 yellow/data wire (+ 4.7 kΩ pullup to 3.3 V)
EZO-pH RX (data from EZO) | GPIO 16 | EZO carrier board TX pin
EZO-pH TX (data to EZO) | GPIO 17 | EZO carrier board RX pin
DAC trend output (optional) | GPIO 25 | Isolated DAC stage → aquarium controller input
3.3 V | 3V3 pin | DS18B20 red wire; relay module VCC
Ground | GND pin | DS18B20 black wire; relay module GND

## DS18B20 Temperature Probe

The 4.7 kΩ resistor connects between the data line (GPIO 14) and the 3.3 V rail. This pullup is mandatory — the DS18B20 will not respond without it.

DS18B20 red wire ► ESP32 3.3V

DS18B20 black wire ► ESP32 GND

DS18B20 yellow wire ► ESP32 GPIO 14 ◄── also connect 4.7kΩ to 3.3V here

## Atlas EZO-pH (UART Mode)

Connect the EZO circuit to its Electrically Isolated Carrier Board following Atlas’s documentation. Then wire the carrier board to the ESP32:

Carrier board TX ► ESP32 GPIO 16

Carrier board RX ► ESP32 GPIO 17

Carrier board VCC ► ESP32 3.3V (check your carrier board’s voltage spec)

Carrier board GND ► ESP32 GND

⚠ The carrier board’s power and ground must NOT share rails with pump drivers. Run dedicated wires from the ESP32 to the carrier board. Never daisy-chain through the relay module’s power bus.

## Relay Module Notes

Most 4-channel relay modules are active-LOW: the relay activates when the signal pin is pulled LOW (0V). The firmware uses active-HIGH logic (writes HIGH to turn the pump ON). If your pumps run continuously at startup and stop when commanded, your relay is active-LOW. Fix it by either:

- Buying an active-HIGH relay module, or
- Swapping the pump wiring from the NO (normally open) to the NC (normally closed) terminal on each relay

## DAC Trend Output (Optional)

GPIO 25 produces a 0–3.3 V analog signal (8-bit resolution) representing your alkalinity across the configured range. The default mapping is 6 dKH = 7.60 fake-pH and 12 dKH = 8.30 fake-pH.

⚠ This output cannot connect directly to a controller’s pH/BNC input. A real pH input expects a millivolt-scale electrode signal. You need an isolated op-amp buffer or precision DAC board between GPIO 25 and your controller. If you don’t have one, read results from the Serial Monitor instead.

# 4. Software Setup

## Step 1 — Install Arduino IDE

Download from arduino.cc/en/software. Install version 2.x.

## Step 2 — Add ESP32 Board Support

1. Open Arduino IDE
2. Go to File → Preferences
3. In “Additional boards manager URLs” paste:

https://raw.githubusercontent.com/espressif/arduino-esp32/gh-pages/package_esp32_index.json

4. Click OK
5. Go to Tools → Board → Boards Manager
6. Search “esp32” and install esp32 by Espressif Systems

## Step 3 — Install Libraries

Go to Tools → Manage Libraries and install both of these:

- OneWire by Paul Stoffregen
- DallasTemperature by Miles Burton

These libraries are only needed when SIMULATION_MODE is set to false. You can skip this step for initial bench testing.

## Step 4 — Load the Firmware

7. Download the file alkalinity_monitor_v2_1.ino
8. Create a folder named exactly: alkalinity_monitor_v2_1
9. Place the .ino file inside that folder
10. Open the .ino file in Arduino IDE

⚠ The folder name must exactly match the filename. Arduino IDE requires this.

## Step 5 — Select Your Board

Go to Tools → Board → esp32 → ESP32 Dev Module

Set Upload Speed to 921600. Set Port to whichever COM port appears when you plug in the ESP32.

## Step 6 — Compile and Upload (Simulation Mode)

The file opens with SIMULATION_MODE true at the top. Leave it there for now. Click the checkmark (✓) to verify it compiles without errors. Then click the arrow (→) to upload.

In simulation mode the device runs through the full cycle using fake sensor data. This lets you verify the software, EEPROM, and Serial communication before connecting any hardware.

# 5. First-Time Setup and Calibration

## Day 1 — Set Your Reference Anchor

This is the most important step. Do it once when you first build the device.

11. Fill your reference reservoir with water drawn directly from your tank. Use 500–700 mL. Seal it completely and tightly.
12. Test that same water with your best manual kit (Salifert, Hanna HI772, or equivalent). Write down the result in dKH.
13. Open the Serial Monitor in Arduino IDE: Tools → Serial Monitor. Set baud rate to 115200.
14. Type the command below and press Enter (replace 8.20 with your actual measurement):

CAL 8.20

15. You should see: Anchor saved: 8.20 dKH
16. Power-cycle the ESP32 (unplug and replug). Type STATUS and confirm the anchor is still stored.

Re-anchor whenever you remake the reference reservoir, or if manual kit checks consistently differ from this device by more than 0.5 dKH. Just re-test the reference water and send a new CAL command.

## Calibrate the pH Probe

Before switching to real sensor mode, calibrate the EZO-pH using pH buffer solutions. Two-point calibration (pH 7.00 and pH 4.01) is standard.

17. Place the probe in pH 7.00 buffer. Wait 60 seconds for stability. Send to EZO via Serial Monitor:

Cal,mid,7.00

18. Place probe in pH 4.01 buffer. Wait 60 seconds. Send:

Cal,low,4.01

Recalibrate the probe every 1–3 months, or whenever results seem inconsistent with your manual kit.

## Switch to Real Hardware Mode

Once wiring is complete and the probe is calibrated:

19. Open alkalinity_monitor_v2_1.ino
20. Find line 1 at the top of the file:

#define SIMULATION_MODE true

21. Change it to:

#define SIMULATION_MODE false

22. Compile and upload

# 6. Normal Operation

Once installed and anchored, the device runs automatically. Every 4 hours it completes one full measurement cycle:

23. Draws 30 mL from the sealed reference reservoir, aerates 10 minutes, averages pH over 60 seconds
24. Returns the reference water to its sealed reservoir
25. Rinses the chamber twice with tank water
26. Draws 30 mL from your sump, aerates 10 minutes, averages pH over 60 seconds
27. Calculates alkalinity and reports the result
28. Outputs the trend voltage on GPIO 25 (if wired to controller)

## Serial Monitor Commands

Type any of these commands in the Serial Monitor (baud 115200) and press Enter:

Command | What it does
CAL 8.20 | Set a new reference anchor. Replace 8.20 with your actual titration result.
STATUS | Shows the current anchor value and whether simulation mode is on.
RUN | Triggers an immediate test cycle without waiting 4 hours.
PUMPS_OFF | Emergency stop. Immediately turns off all pumps and aborts the active cycle.

## Reading the Output

Serial Monitor output from a successful cycle looks like this:

[REF] T=25.40 C Averaging pH for 60 s...

pH=8.0982 SD=0.00321 n=30

[TANK] T=25.38 C Averaging pH for 60 s...

pH=8.1204 SD=0.00289 n=29

RESULT: 9.12 dKH

pH ref: 8.0982

pH tank: 8.1204

DeltapH tank-ref: +0.0222

Reading | What it likely means
Result ≈ anchor | Tank alkalinity matches reference — stable
Result rising cycle over cycle | Dosing too high, or tank consuming less than expected
Result falling cycle over cycle | Dosing too low, or coral consumption has increased
SD warning printed | CO₂ may not have equilibrated. Check airstone; consider increasing aeration time.
Result jumps ±1+ dKH between cycles | Probe needs cleaning or recalibration
Too few valid pH readings | Probe not responding — check wiring and power to EZO

# 7. Maintenance

Frequency | Task
Weekly | Visually inspect tubing for kinks, algae, or small leaks
Monthly | Calibrate pH probe with pH 7.00 and pH 4.01 buffers
Monthly | Test reference reservoir water with manual kit. If it has shifted more than 0.3 dKH, re-anchor with the CAL command.
Every 3–6 months | Replace the reference reservoir water entirely. Fill fresh from tank, titrate, re-anchor.
As needed | Clean reaction chamber with dilute white vinegar, rinse thoroughly with RO water
Every 6–12 months | Replace peristaltic pump tubing (PharMed BPT tubing lasts longest in saltwater environments)

# 8. Troubleshooting

### Pumps activate backwards

Symptoms: pumps run at startup and stop when commanded. Cause: relay module is active-LOW. Fix: move wiring from the NO terminal to the NC terminal on each relay, or buy an active-HIGH relay module.

### EZO returns no response at boot

Check that TX and RX are not swapped (EZO TX goes to ESP32 GPIO 16, EZO RX goes to GPIO 17 — not the other way). Confirm the carrier board has power. Try sending the letter i in Serial Monitor as a communications test.

### pH readings show high SD — equilibration warning printed

The airstone may be blocked or the air pump may be too weak. Remove and clean the airstone in fresh water. If the problem persists, increase AERATE_TIME_MS from 600000 (10 min) to 900000 (15 min) in the firmware.

### Results consistently differ from manual kit by 1+ dKH

Re-anchor: test your reference reservoir with the manual kit and send CAL with the new value. If the discrepancy remains after re-anchoring, clean and recalibrate the pH probe with fresh buffers.

### Result shows NAN or outside valid range error

The pH probe returned an invalid reading. Check that the probe is fully submerged in the reaction chamber, the EZO is powered, and the carrier board isolation is intact. Also verify the probe is not cracked or fouled.

### Device halts at startup with No valid anchor message

This is normal on first boot before any anchor has been set. Open Serial Monitor, type CAL followed by your titration result (example: CAL 8.20), and press Enter.

### DS18B20 reads -127°C or shows disconnected

The 4.7 kΩ pullup resistor between GPIO 14 and 3.3 V is missing or not making contact. Verify the resistor is in place and that all three DS18B20 wires are securely connected.

CO₂ exchange does not affect alkalinity. Total alkalinity is a conservative property of the carbonate system — CO₂ dissolving into or leaving water produces changes in pH and DIC but the H⁺ and HCO₃⁻ cancel in the TA equation. The reservoir only needs protection against liquid evaporation, not CO₂. A PTFE vent is sufficient and correct. A truly CO₂-sealed reservoir is neither necessary nor achievable with a peristaltic pump loop.

## Safety Notes

⚠ Do not run unattended near the aquarium until you have verified all pump timing with plain water and confirmed there are no leaks.

⚠ Label the DAC trend output on your controller clearly. The voltage on GPIO 25 is a synthetic trend signal, NOT real tank pH.

- Add a drip tray under all fluidic components
- Keep all electrical connections away from water; seal exposed connections with silicone
- Add float switches or level sensors before leaving the device running overnight

TelegrahamTested • DIY Ratiometric Alkalinity Monitor v2.1 • CC BY-NC-SA 4.0

Build Guide v2.2

DIY Ratiometric Alkalinity Monitor TelegrahamTested
