nottelegraham/AlkTrack/DIY_Alkalinity_Monitor_Changelog.docx

AlkTrack Firmware Changelog

TelegrahamTested • Current: v3.0 • CC BY-NC-SA 4.0

This changelog summarizes the evolution of AlkTrack through v3.0. Version 3.0 is a major hardware and firmware revision that adds acid titration mode and stepper-driven volume control.

# v3.0 CURRENT — Stepper architecture + dual operating mode

Type | Description
CHANGED | All peristaltic pumps are now stepper-driven using STEP/DIR control through A4988 or DRV8825 drivers. Volume is controlled by calibrated step count, not relay runtime.
ADDED | Dual operating modes: MODE PHDI for pH differential/ratiometric trend monitoring and MODE TITR for acid titration.
ADDED | Acid titration workflow: fixed sample volume, acid dosing via Pump D, pH endpoint detection, Gran fit when possible, fixed endpoint fallback, and waste drain through Pump C.
FIXED | Titration unit conversion. Correct formula is dKH = (N_acid × Ve_mL / V_sample_mL) × 2800. Earlier draft text incorrectly showed × 2.8.
ADDED | Titration calibration fields: acidNormality, sampleStepsPerML, acidStepsPerML, sampleML, doseMl, and mode.
ADDED | Serial commands: MODE PHDI, MODE TITR, CAL ACID, CAL SAMPLEML, CAL DOSE, CAL SAMPLESPM, CAL ACIDSPM.
CHANGED | EEPROM signature updated to 0xA11C0003 so v2.x data is reinitialized safely.
NOTE | Hardware changes required: stepper drivers, stepper-compatible pumps, 12V 5A supply, acid reagent reservoir, and waste container for titration mode.

# v2.2 PREVIOUS — Two-pump pH differential experiment

Type | Description
CHANGED | Pump B was made reversible so pH differential mode could return tank sample water to the sump without a waste line.
REMOVED | Pump C was removed in the v2.2 pH-differential-only concept.
NOTE | This architecture is superseded by v3.0 when acid titration mode is enabled, because titration mode requires acid waste handling.

# v2.1.x — Deployable pH differential firmware patches

Type | Description
FIXED | ESP32 SPI flash pin collision by moving pump and air pump pins away from GPIO 6-11.
FIXED | Blocking delay loops replaced with non-blocking loops that accept serial commands during aeration and sleep.
FIXED | Real sensor code added for Atlas EZO-pH UART and DS18B20 temperature probe.
FIXED | EZO temperature compensation added before pH reads.
ADDED | pH averaging window and standard-deviation warning.
ADDED | RUN, PRIME, and PUMPS_OFF commands.

# v2.0 BASELINE — pH differential calculation cleanup

Type | Description
FIXED | Alkalinity unit mismatch in pH differential formula. Internal math uses eq/L and converts final result to dKH.
CHANGED | K1, K2, and KB moved from empty placeholders to fixed 25 C / 35 ppt constants for trend-only use.
ADDED | Simulation mode, EEPROM calibration structure, BNC/DAC trend output hook, double-rinse flush, and basic fault checks.

# Version 3.0 design note

AlkTrack v3.0 is intentionally documented as a dual-mode hobby/education platform. pH differential mode remains a reagent-free trend estimator. Titration mode is a true acid titration method and should be treated as reagent-consuming, waste-producing, and calibration-sensitive.

TelegrahamTested • AlkTrack v3.0 • CC BY-NC-SA 4.0
