nottelegraham/AlkTrack/Version 2/DIY_Alkalinity_Monitor_Changelog.docx

Firmware Changelog

DIY Ratiometric Alkalinity Monitor

TelegrahamTested • Current version: v2.2

This document records every change made to the firmware since the original blueprint draft. Versions follow semantic numbering: the first digit marks a complete rewrite, the second marks new features or significant fixes, the third marks patches and bug fixes.

ADDED | FIXED | CHANGED | REMOVED | NOTE

v2.2 | CURRENT | Two-pump architecture — Pump C removed, Pump B now reversible

Type | Description

CHANGED

Pump B is now reversible — Pump C (waste drain) removed entirely.

- v2.1 required three pumps: Pump A (reversible, reservoir), Pump B (one-way, tank in), Pump C (one-way, waste drain).
- v2.2 removes Pump C. Pump B is now reversible, returning tank and rinse water to the sump after each measurement.
- No waste line, waste container, or drain connection required.
- GPIO assignments are unchanged. GPIO 5 was PUMP_WASTE (Pump C); it is now PUMP_TANK_REV (Pump B reverse). Same relay channel IN4, new logical function.
- Relay wiring: IN1 = Pump A fwd (GPIO 23), IN2 = Pump A rev (GPIO 19), IN3 = Pump B fwd (GPIO 18), IN4 = Pump B rev (GPIO 5).

CHANGED | PUMP_TANK renamed PUMP_TANK_FWD, PUMP_WASTE renamed PUMP_TANK_REV throughout firmware. - All runTankCycle() drain calls now use PUMP_TANK_REV instead of PUMP_WASTE. - All runFlushCycle() drain calls now use PUMP_TANK_REV instead of PUMP_WASTE. - Serial output: [TANK] Draining... replaced with [TANK] Returning water to sump...
CHANGED | PRIME command updated for two-pump layout. - Step 3 now primes Pump B forward (sump to chamber, 20 s). - Step 4 now primes Pump B reverse (chamber to sump, 20 s). - Previously steps 3 and 4 primed Pump B and Pump C separately.
NOTE | Hardware change required: Pump B must be a reversible pump (same model as Pump A). Pump C is removed. Rewire relay IN4 from Pump C motor to Pump B reverse motor terminals.

Prompted by: user design decision — eliminate waste drain, return all water to sump.

v2.1.2 | PATCH | PRIME command for first-run tubing priming

Type | Description
ADDED | PRIME serial command — primes all tubing lines on first install. - Runs four stages in sequence: Pump A forward 30 s, Pump A reverse 30 s, Pump B forward 20 s, Pump B reverse 20 s. (Note: v2.1.2 originally referenced Pump C; updated in v2.2 to match two-pump design.) - Designed for first-install use when all tubing is full of air. Standard FILL_TIME_MS was calibrated for water-filled lines and insufficient for initial priming. - Also serves as a recovery flush after PUMPS_OFF leaves the chamber in an unknown state. - Progress printed to Serial Monitor after each stage.
CHANGED | All Serial.println command lists updated to include PRIME. - Startup message now reads: CAL <dKH> STATUS PUMPS_OFF RUN PRIME - Inter-cycle sleep message updated identically.

Prompted by: first-run setup question — how to initially activate the reference reservoir.

v2.2 | PATCH | Reference water abort safety fix

Type | Description

FIXED

Reference water stranded in chamber on PUMPS_OFF during reference aeration (Bug 6).

- If PUMPS_OFF fired during runAeration() inside runReferenceCycle(), the function returned immediately on the g_abortCycle check without running PUMP_REF_REV.
- Reference water was left in the chamber. The next cycle's PUMP_REF_FWD fill would add more water to an already-full chamber, risking overflow and diluting the reference with tank water on the following tank fill.
- The tank cycle already handled abort correctly (draining to waste before returning). The reference cycle now matches: PUMP_REF_REV always runs before returning on abort.
- Both abort check points in runReferenceCycle() are fixed: the check after runAeration() and the check after runSettleDelay().

Identified during: end-to-end process review ("will the tester work?").

v2.1 | RELEASE | First deployable version — five v2 bugs resolved

Type | Description
FIXED | Bug 1 — ESP32 SPI flash pin collision (CRITICAL). - PUMP_TANK reassigned: GPIO 6 → GPIO 18. - PUMP_WASTE reassigned: GPIO 7 → GPIO 5. - AIR_PUMP reassigned: GPIO 8 → GPIO 4. - GPIO 6–11 are connected to internal SPI flash on all ESP32 DevKit boards. Driving them as outputs corrupts flash or crashes the board on every pump cycle. Added prominent warning comment in pin definitions.
FIXED | Bug 2 — all delays fully blocking. - runAeration() refactored to a millis()-based non-blocking loop calling handleSerialCommands() every 100 ms. PUMPS_OFF, STATUS, CAL, and RUN now work during 10-minute aeration. - sleepUntilNextCycle() refactored identically. All commands work during the 4-hour inter-cycle sleep. - runSettleDelay() added as a new non-blocking settle function that also checks g_abortCycle. Previously a plain delay() call.
FIXED | Bug 3 — real sensor code absent. - Atlas EZO-pH UART interface implemented in #else branch: sends R\r, waits 1000 ms, reads and validates response. - DS18B20 OneWire implemented in #else branch: requestTemperatures(), getTempCByIndex(0), disconnect detection returns NAN. - SIMULATION_MODE false now compiles to functional hardware code. Libraries OneWire and DallasTemperature required when false.
FIXED | Bug 4 — EZO temperature compensation not called before pH reads. - ezo_setTempComp(tempC) added and called at the start of each readAveragedSample() session. - Sends T,XX.XX\r to EZO before averaging begins so the Nernst slope correction uses the measured temperature. - In SIMULATION_MODE the function is a safe no-op with (void)tempC to suppress the unused-parameter warning.
FIXED | Bug 5 — pHStdDev computed but silently discarded. - PH_SD_WARN_THRESHOLD constant added, default 0.010. - After averaging, SD checked against threshold. If exceeded, warning printed noting likely incomplete CO₂ equilibration and suggesting AERATE_TIME_MS increase.
ADDED | g_forceRun and g_abortCycle global flags introduced. - g_abortCycle set by PUMPS_OFF; checked in non-blocking loops to exit cleanly. - g_forceRun set by RUN command; checked in sleepUntilNextCycle() to exit early.
ADDED | RUN serial command added. - Triggers an immediate measurement cycle from the inter-cycle sleep without waiting for TEST_INTERVAL_MS.
ADDED | Complete forward declarations for all functions. - Arduino IDE auto-generates prototypes; this was missing for non-IDE build environments (PlatformIO, Makefile). - Verified with g++ -std=c++11 -Wall -Wextra: zero errors, zero code warnings.

Verified with: g++ syntax check using Arduino/ESP32 stub headers. All 5 bugs confirmed resolved, formula math verified against validated Python carbonate chemistry engine.

v2 | BASELINE | Uploaded blueprint revision — not deployable

Source: Alkalinity_Tester_Microcontroller_Code_v2.docx (uploaded document). Significant redesign over v1 but five bugs prevent deployment.

Type | Description
FIXED | Units mismatch in master formula (from v1). - TA_ref_anchor now converted from dKH to eq/L (× 1/2800) before formula runs. - Result converted back to dKH (× 2800) at output. - BA_ref and BA_tank remain in eq/L throughout. All arithmetic in consistent units. - Note: bug was self-masking in v1 because BA ≈ 2% of TA; numerical error was only ∼0.004 dKH at typical reef values, but conceptually wrong.

CHANGED

K1, K2, KB functions changed from unimplemented stubs to fixed 25 °C / 35 ppt constants.

- K1 = 1.42 × 10⁻⁶ (Lueker et al. 2000, 25 °C, S=35, error vs exact: 0.13%)
- K2 = 1.08 × 10⁻⁹ (Lueker et al. 2000, 25 °C, S=35, error vs exact: 0.14%)
- KB = 2.54 × 10⁻⁹ (Dickson 1990, 25 °C, S=35, error vs exact: 0.53%)
- Temperature argument still accepted but not used. Documented design choice: for 35 ppt trend-only use, K values largely cancel in the ratio, and error from fixed constants is under 0.05 dKH across 23–27 °C.
- Stubs in v1 had comments reading "implement Millero polynomial here" with no actual polynomial.

ADDED | SIMULATION_MODE compile flag. true by default. Allows bench testing without hardware; sensor functions return stable pseudo-values in simulation mode.
ADDED | pH averaging window replacing single read. - 30 readings over 60 seconds (READ_WINDOW_MS / READ_PERIOD_MS). - Mean and population standard deviation computed. - Minimum 5 valid reads required; returns failure if fewer received. - pHStdDev computed and stored in SampleReading struct but value unused — no action taken on high variance (Bug 5, fixed in v2.1).
ADDED | EEPROM CalibrationData struct with uint32_t signature (0xA11C0DE5) for validation across power cycles.
ADDED | BNC/DAC fake-pH trend output. dKH result linearly mapped to synthetic 0–3.3 V signal on GPIO 25 for aquarium controller logging.
ADDED | Double-rinse flush cycle between reference and tank measurements to reduce cross-contamination.
ADDED | Fault range checks on pH (6.5–9.2), temperature (15–35 °C), and final result (3–20 dKH). Out-of-range values abort the cycle.
NOTE | Five bugs present in v2, resolved in v2.1: - Bug 1: PUMP_TANK=6, PUMP_WASTE=7, AIR_PUMP=8 — all ESP32 SPI flash pins. - Bug 2: All delays blocking — no serial commands processed during aeration or sleep. - Bug 3: Real sensor code absent — #else branches return NAN with TODO comments. - Bug 4: EZO temperature compensation never called. - Bug 5: pHStdDev computed and silently discarded.

v1 | REFERENCE | Original blueprint draft — reference only, never deployed

Source: Alkalinity_Tester_Microcontroller_Code.docx (uploaded document). Baseline from original design document.

Type | Description
NOTE | Master formula present but with units mismatch. - TA_ref_anchor described as a dKH value (e.g. 8.2 dKH). - BA_ref and BA_tank computed from BT = 0.000416 (mol/kg) and KB, yielding mol/kg values. - Subtraction (TA_ref_anchor − BA_ref) mixes dKH and mol/kg directly. Self-masking because BA ≈ 2% of TA.
NOTE | get_K1(), get_K2(), get_KB() are unimplemented stubs. - Functions accept a temperature argument in Kelvin but ignore it entirely. - Return hardcoded approximations: pow(10, -5.847), pow(10, -8.966), pow(10, -8.595). - Comments read: "Implement standard seawater K1 polynomial here".
NOTE | read_pH_Probe() returns hardcoded constant 8.15 on every call. No hardware interface.
NOTE | read_Temp_C() returns hardcoded constant 298.15 K on every call. No hardware interface.
NOTE | Single pH reading per measurement. No averaging, no standard deviation.
NOTE | No SIMULATION_MODE compile flag. All sensor stubs silently return fixed values with no indication.
NOTE | Pump pin assignments include ESP32 SPI flash pins. - PUMP_TANK = 6, PUMP_WASTE = 7, AIR_PUMP = 8. - GPIO 6–11 are internal flash on all ESP32 DevKit boards. Cannot be used as GPIO.
NOTE | All delays blocking. delay(AERATE_TIME_MS) and delay(TEST_INTERVAL_MS) prevent all serial processing.
NOTE | No EEPROM signature validation. Raw float read with no sanity check.
NOTE | No BNC/DAC trend output.
NOTE | No flush rinse cycle between reference and tank measurements.
NOTE | No fault range checks on pH, temperature, or result.

TelegrahamTested • DIY Ratiometric Alkalinity Monitor • Firmware Changelog • CC BY-NC-SA 4.0

TelegrahamTested • Current: v2.2 • CC BY-NC-SA 4.0

DIY Ratiometric Alkalinity Monitor Firmware Changelog
